ai6ym/minimum-viable-yagi/stls/tape_yagi_driven_element_holder_pipe-0.75_tape-0.75.stl

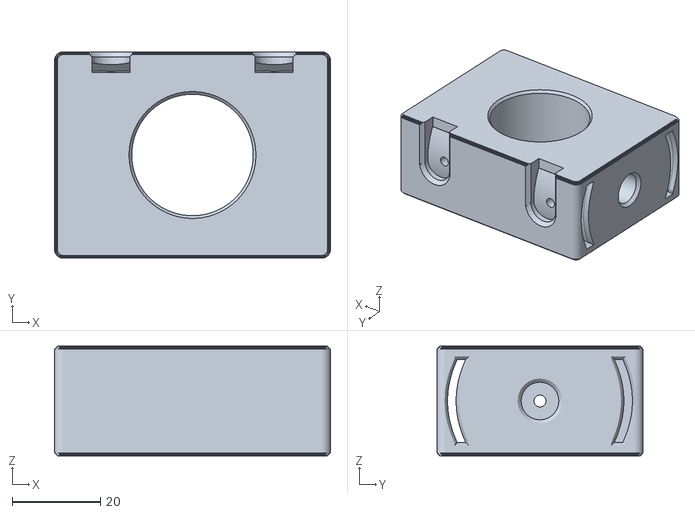
[picture p3: CAD file, 2026-10-23]
stls/tape_yagi_driven_element_holder_pipe-0.75_tape-0.75.stl
62.5 x 46.7 x 24.9
