ai6ym/minimum-viable-yagi/stls/tape_yagi_element_holder_pipe-0.5_tape-1.0.stl

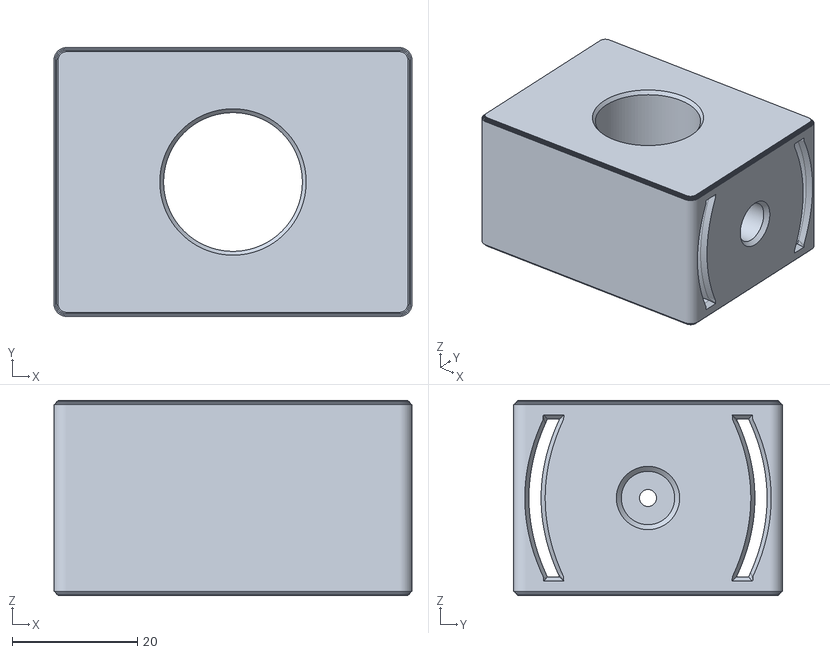
[picture p4: CAD file, 2026-10-23]
stls/tape_yagi_element_holder_pipe-0.5_tape-1.0.stl
57.1 x 42.9 x 31.2
