ai6ym/minimum-viable-yagi/stls/tape_yagi_element_holder_pipe-0.5_tape-0.75.stl

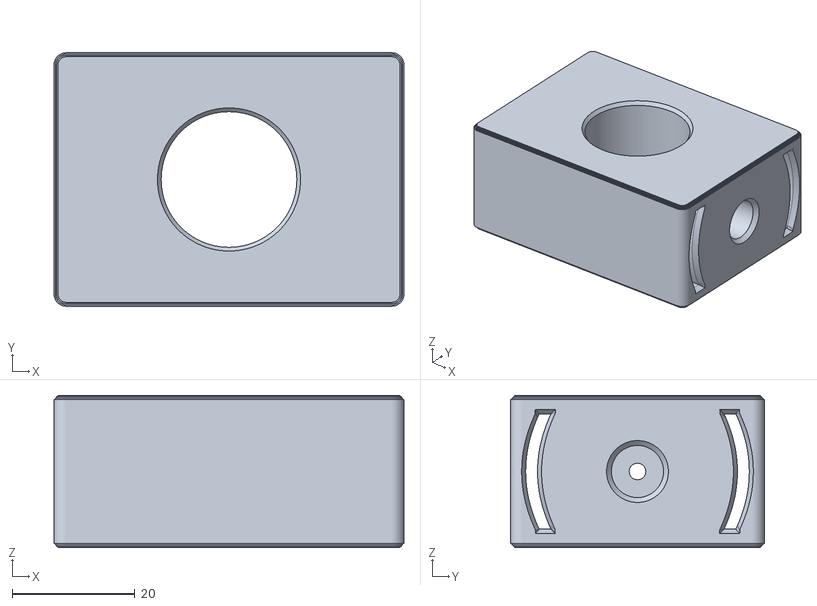
[picture p6: CAD file, 2026-10-23]
stls/tape_yagi_element_holder_pipe-0.5_tape-0.75.stl
57.1 x 41.4 x 24.9
