ai6ym/minimum-viable-yagi/stls/tape_yagi_element_holder_pipe-0.75_tape-1.0.stl

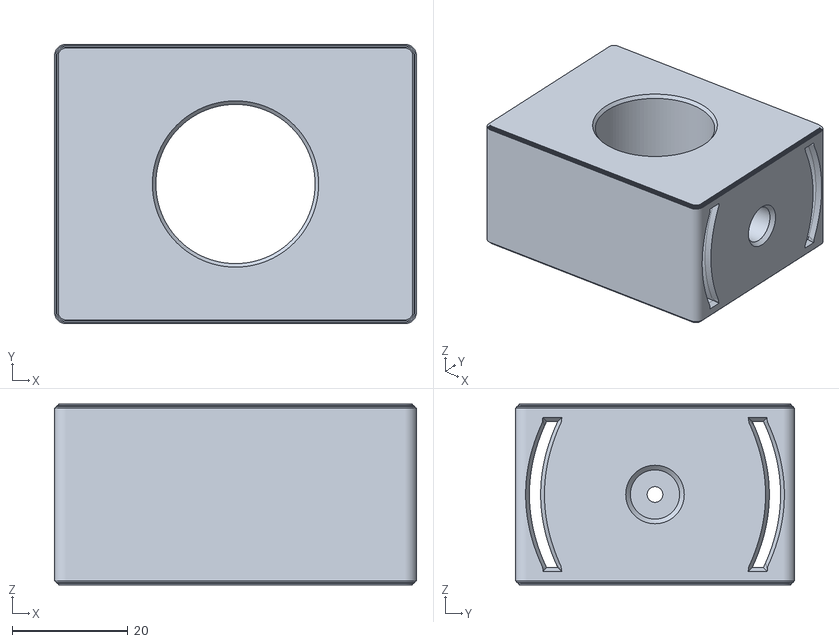
[picture p7: CAD file, 2026-10-23]
stls/tape_yagi_element_holder_pipe-0.75_tape-1.0.stl
62.5 x 48.2 x 31.2
