ai6ym/minimum-viable-yagi/stls/tape_yagi_driven_element_holder_pipe-0.75_tape-1.25.stl

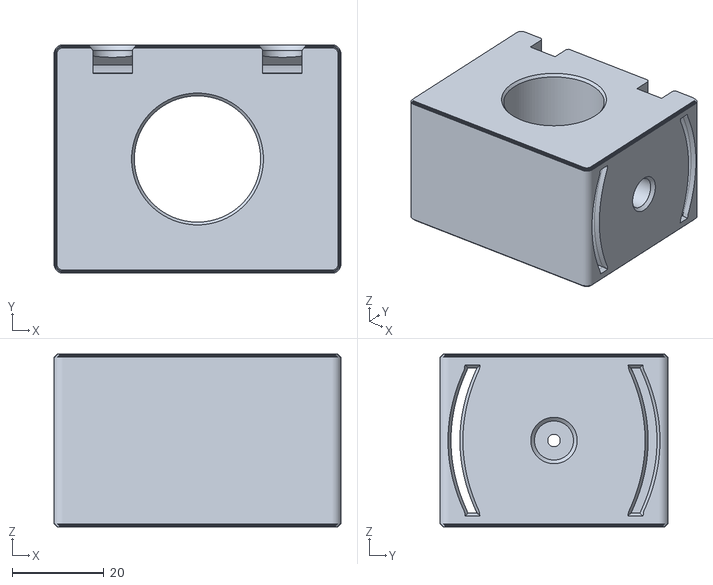
[picture p11: CAD file, 2026-10-23]
stls/tape_yagi_driven_element_holder_pipe-0.75_tape-1.25.stl
62.5 x 49.7 x 37.5
