ai6ym/minimum-viable-yagi/stls/tape_yagi_element_holder_pipe-0.5_tape-1.25.stl

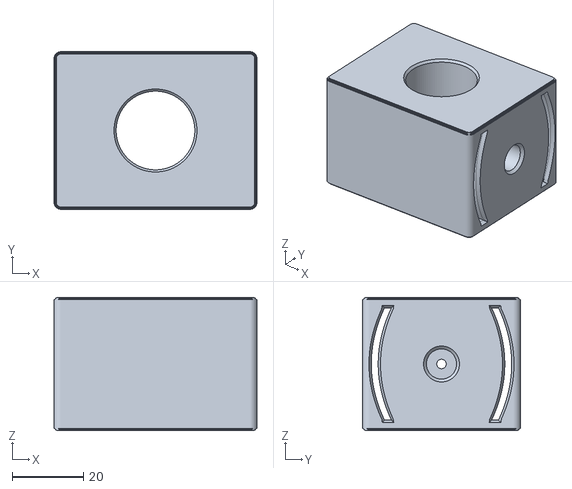
[picture p12: CAD file, 2026-10-23]
stls/tape_yagi_element_holder_pipe-0.5_tape-1.25.stl
57.1 x 44.4 x 37.5
