ai6ym/minimum-viable-yagi/(commit log)

2024-12-24 Initial commit.
    [Tape Measure Yagi - Driven 0.5 Inch Pipe 1.25 Inch Tape.stl, Tape Measure Yagi - Parasitic 0.5 Inch Pipe 1.25 Inch Tape.stl]
2024-12-26 Adding additional variants.
    [Tape Measure Yagi - Driven 0.5 Inch Pipe 1 Inch Tape.stl, Tape Measure Yagi - Driven 0.75 Inch Pipe 1 Inch Tape.stl, Tape Measure Yagi - Driven 0.75 Inch Pipe 1.25 Inch Tape.stl, Tape Measure Yagi - Parasitic 0.5 Inch Pipe 1 Inch Tape.stl, Tape Measure Yagi - Parasitic 0.75 Inch Pipe 1 Inch Tape.stl, Tape Measure Yagi - Parasitic 0.75 Inch Pipe 1.25 Inch Tape.stl]
2025-01-24 Adding images and performance measurements. Correcting instructions to include hairpin match solder step.
2026-10-23 Redesigned OpenSCAD parts, commercial *Minimum Viable Yagi* kit.
    [Tape Measure Yagi - Driven 0.5 Inch Pipe 1 Inch Tape.stl, Tape Measure Yagi - Driven 0.5 Inch Pipe 1.25 Inch Tape.stl, Tape Measure Yagi - Driven 0.75 Inch Pipe 1 Inch Tape.stl, Tape Measure Yagi - Driven 0.75 Inch Pipe 1.25 Inch Tape.stl, Tape Measure Yagi - Parasitic 0.5 Inch Pipe 1 Inch Tape.stl, Tape Measure Yagi - Parasitic 0.5 Inch Pipe 1.25 Inch Tape.stl, Tape Measure Yagi - Parasitic 0.75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]
2026-10-23 Adjust tape slots and regenerate holder presets
    [tape_yagi_driven_element_holder_pipe-0.5_tape-0.75.stl, tape_yagi_driven_element_holder_pipe-0.5_tape-1.0.3mf, tape_yagi_driven_element_holder_pipe-0.5_tape-1.0.stl, tape_yagi_driven_element_holder_pipe-0.5_tape-1.25.stl, tape_yagi_driven_element_holder_pipe-0.75_tape-0.75.stl, tape_yagi_driven_element_holder_pipe-0.75_tape-1.0.stl, tape_yagi_driven_element_holder_pipe-0.75_tape-1.25.stl, tape_ya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]
